newaetech/ChipJabber-Unplugged/docs/img/cj_meterdetail_web.jpg

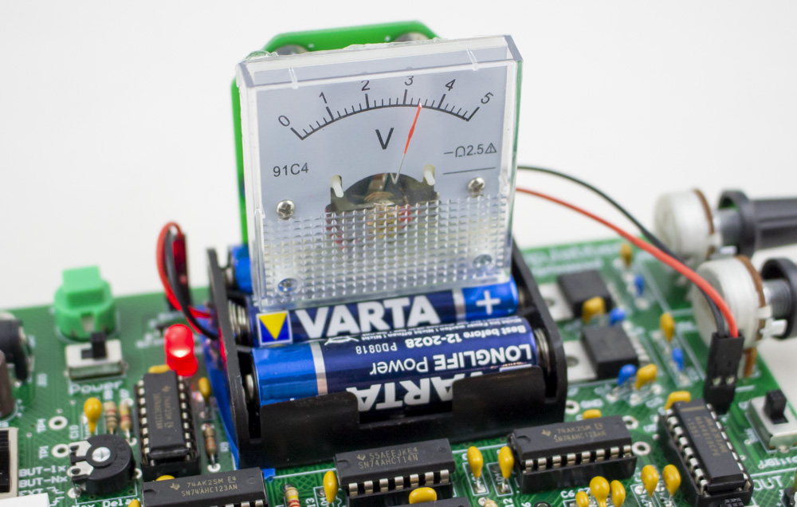
docs/img/cj_meterdetail_web.jpg
