newaetech/ChipJabber-Unplugged/docs/img/cj_notduino_demo_web.jpg

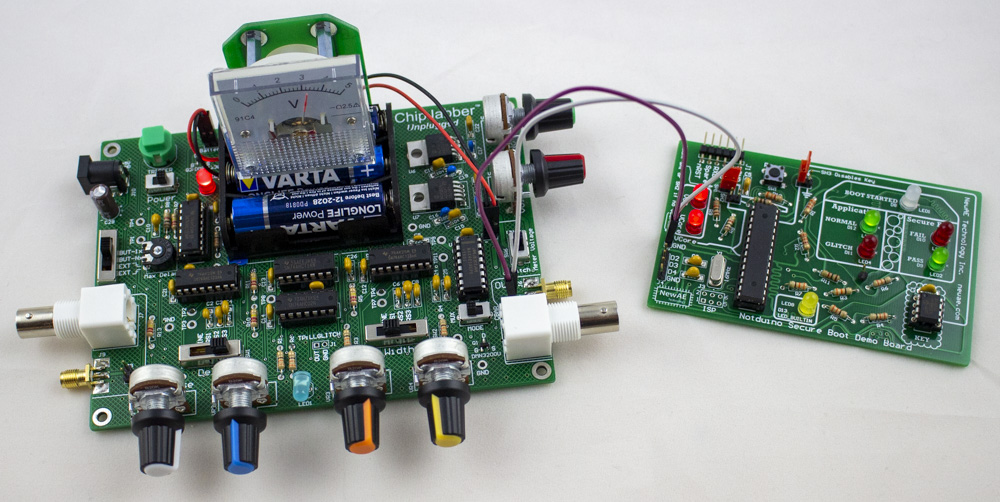
docs/img/cj_notduino_demo_web.jpg
