newaetech/ChipJabber-Unplugged/docs/img/cj_pcb_detail_web.jpg

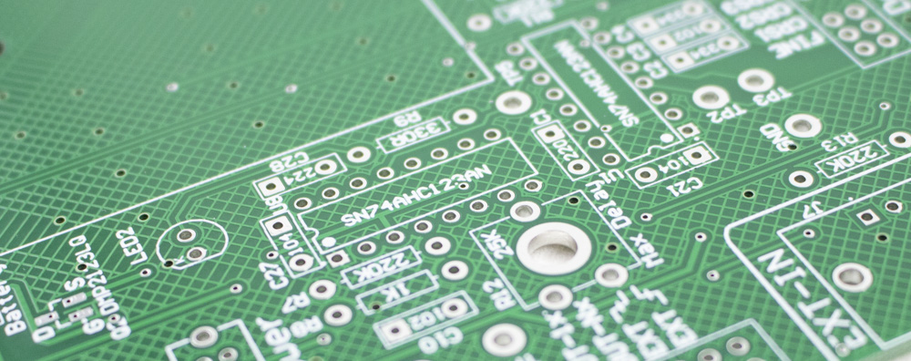
docs/img/cj_pcb_detail_web.jpg
