newaetech/ChipJabber-Unplugged/chipjabber-simple-pcb/chipjabber-unplugged-simplepcb-schematic.PDF

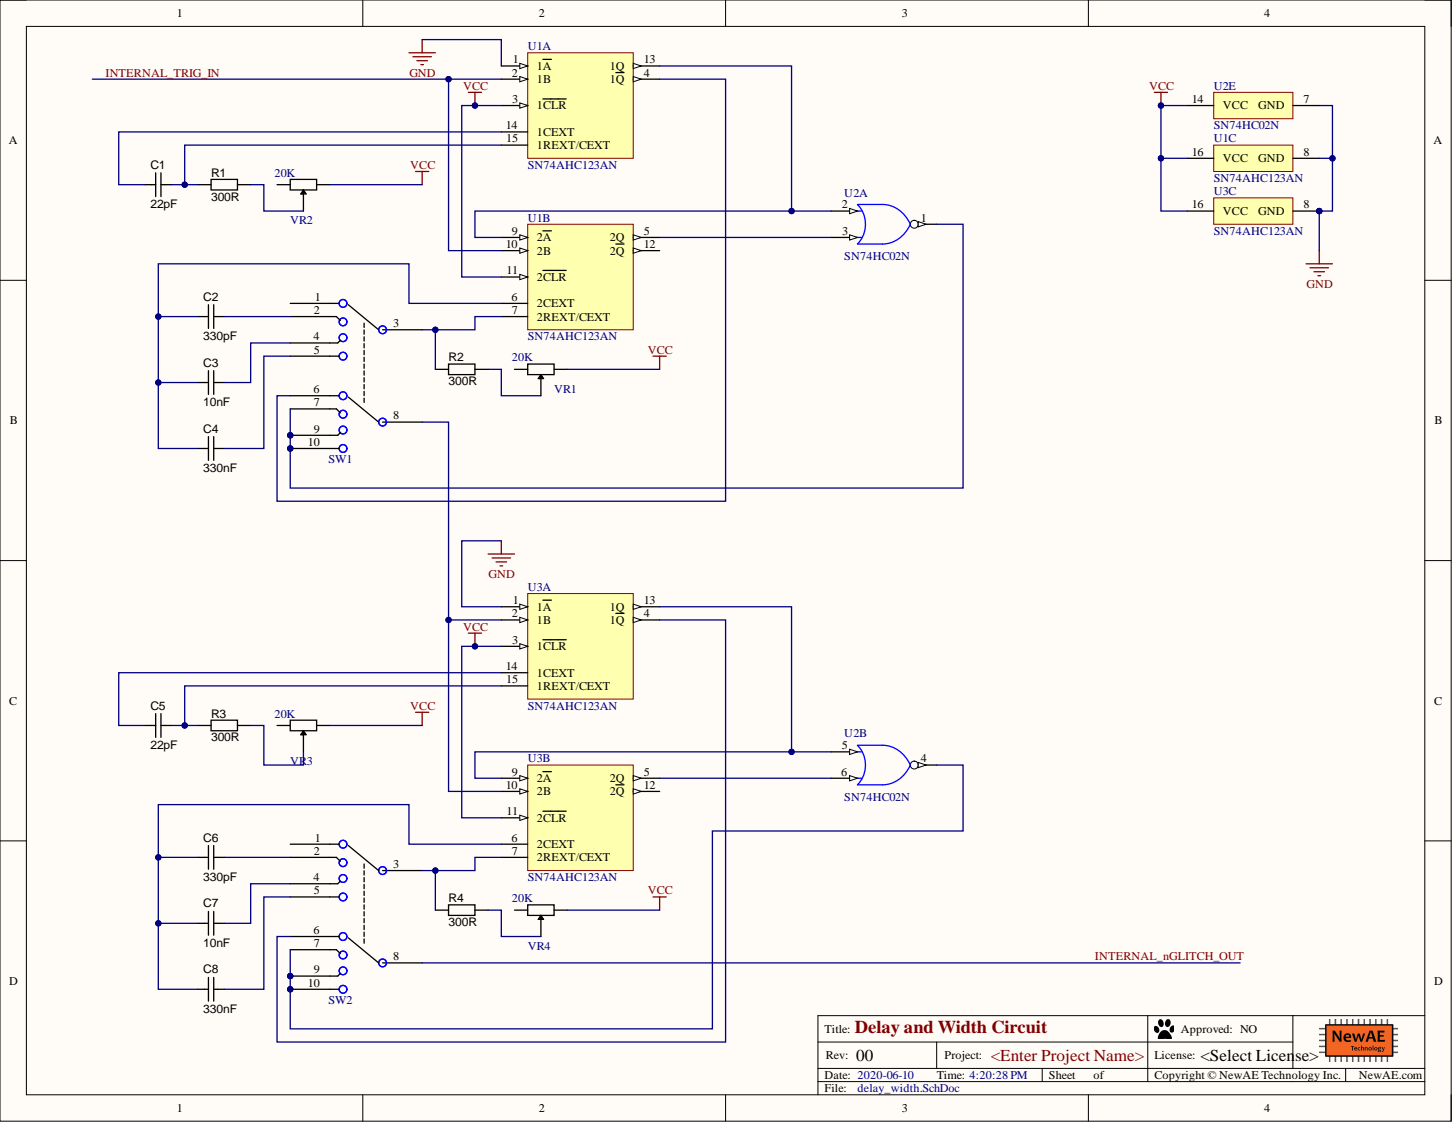
[picture p14: page 1]

1B 2 1CLR 3

1CEXT 14

VCC | | 1CLR 3

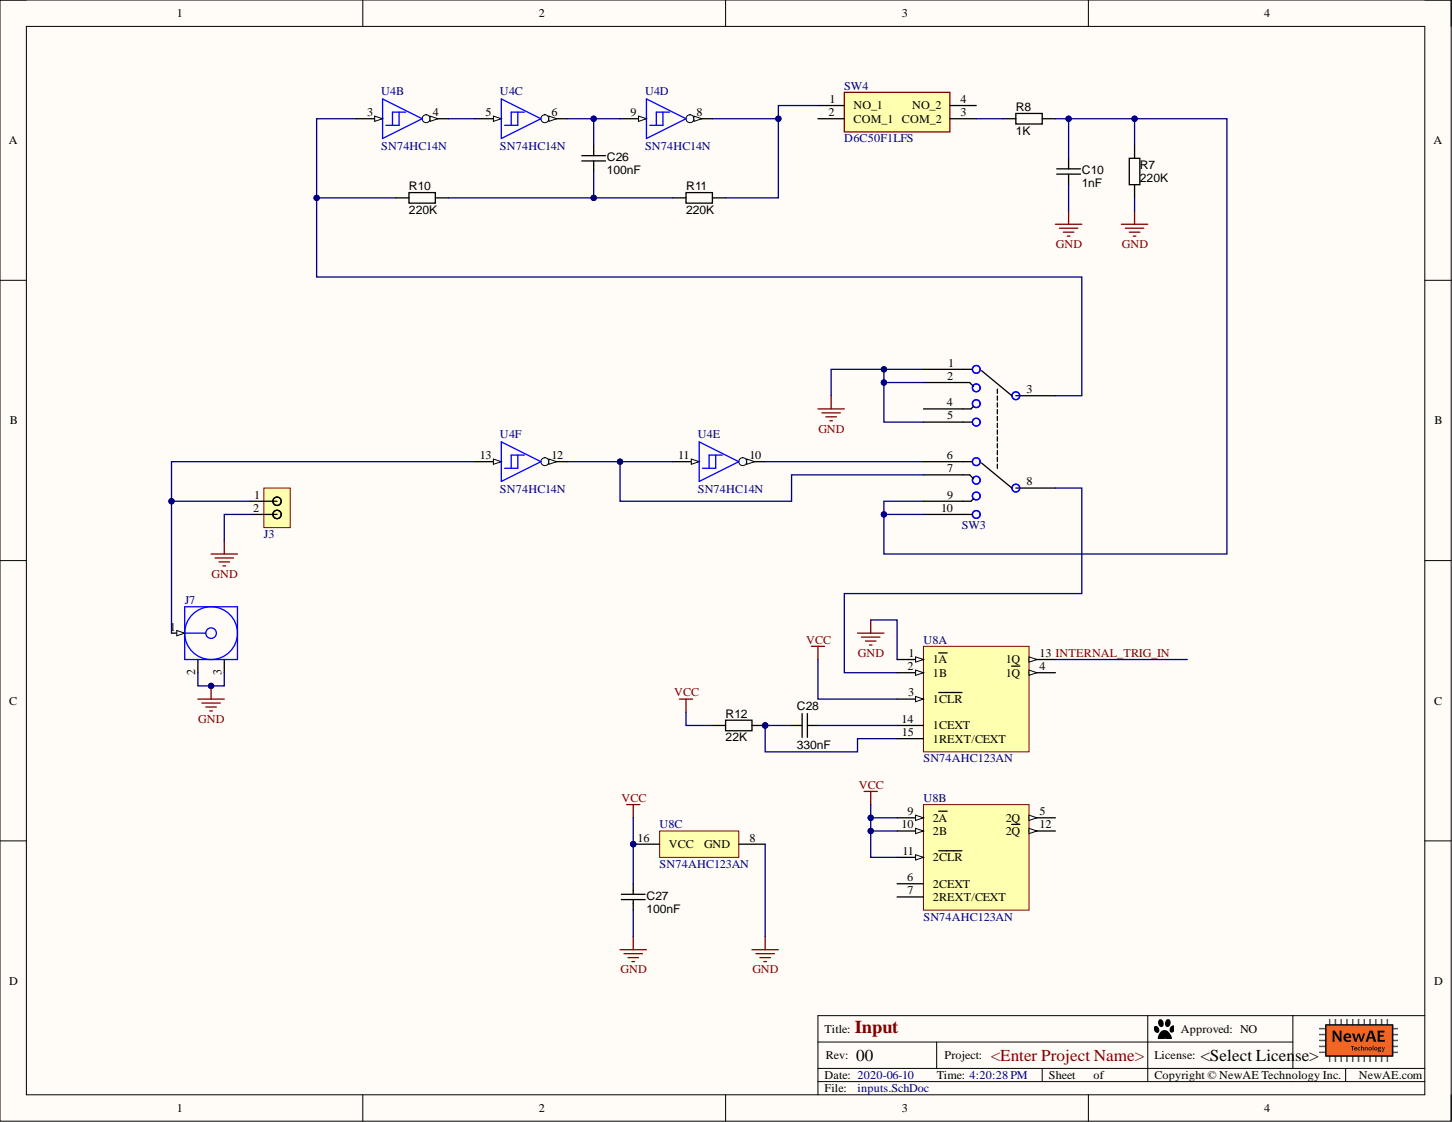
[picture p15: page 2]

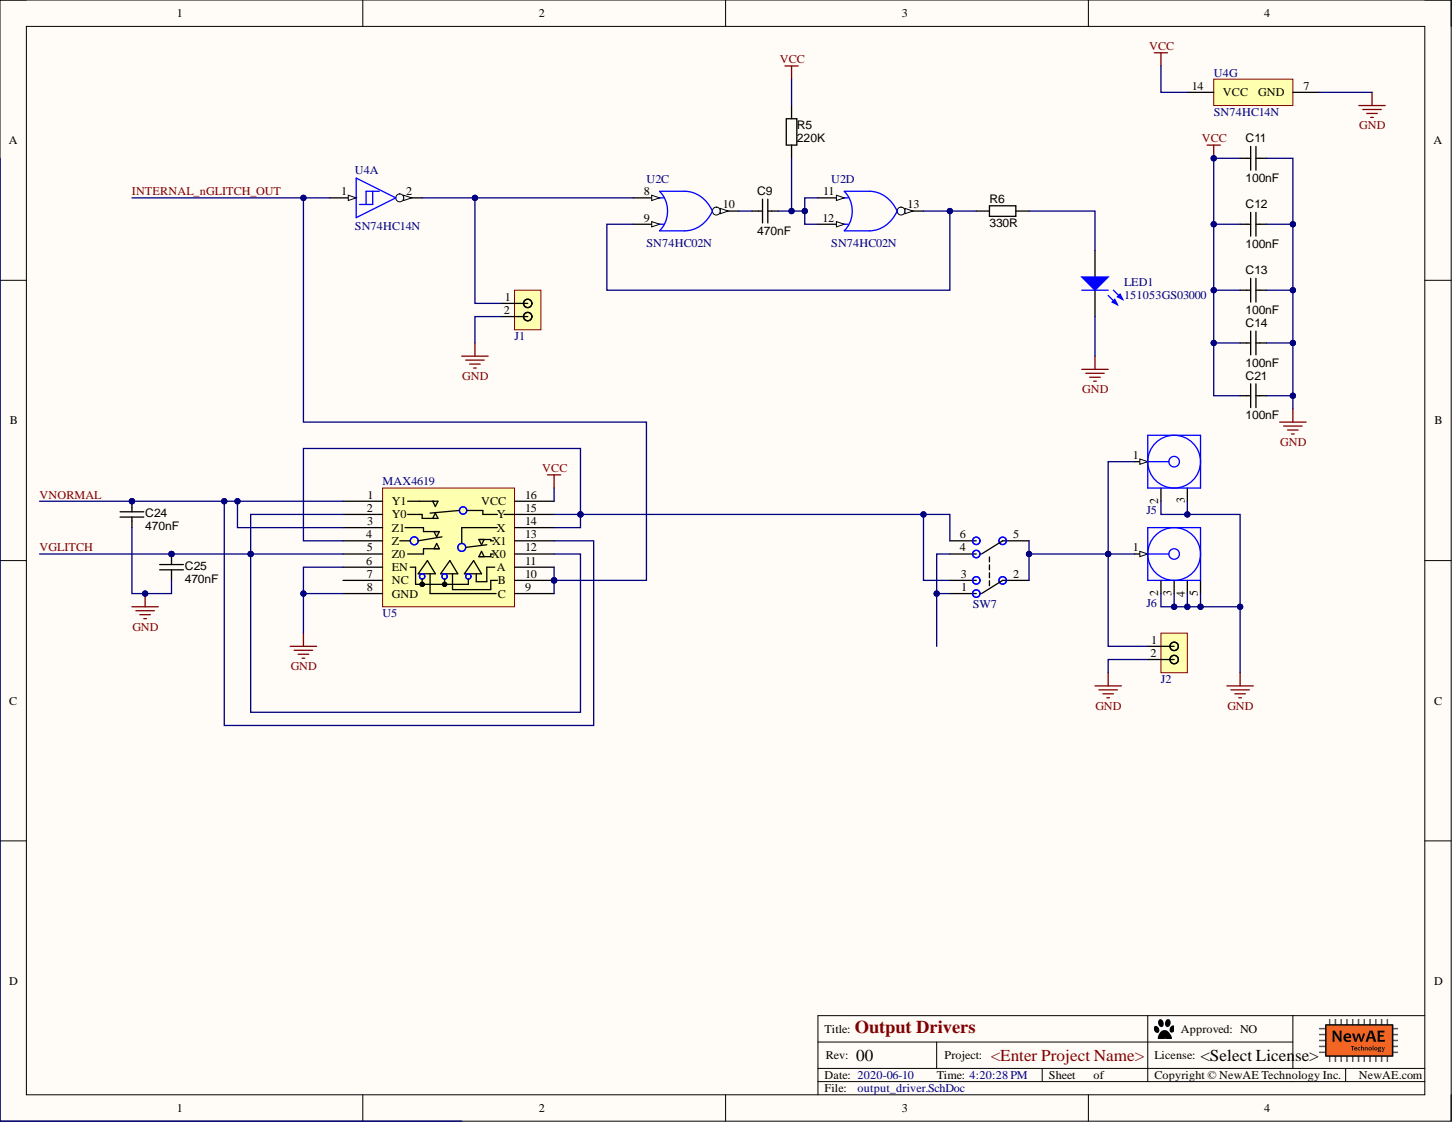
[picture p16: page 3]

MAX4619 | VCC

GND 8 Z1 3 | 9 B 10 A 11 X0 12 X1 13 X 14 Y 15 VCC 16

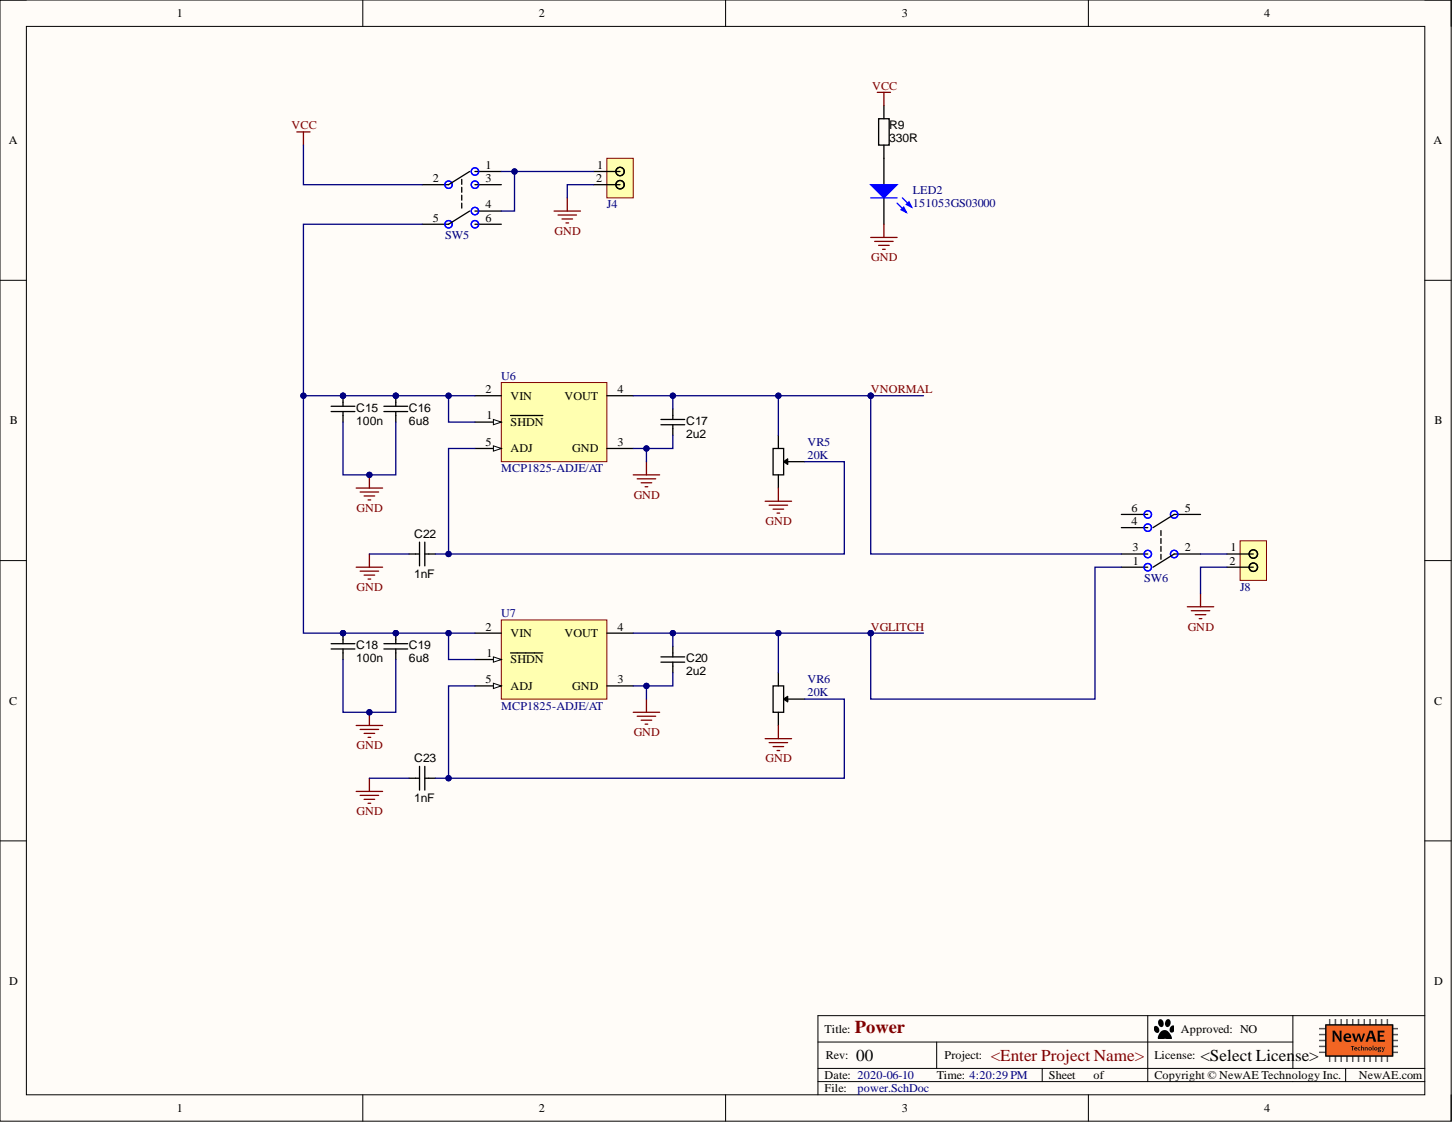
[picture p17: page 4]
