newaetech/ChipJabber-Unplugged/chipjabber-simple-pcb/chipjabber-unplugged-pcbprint.PDF

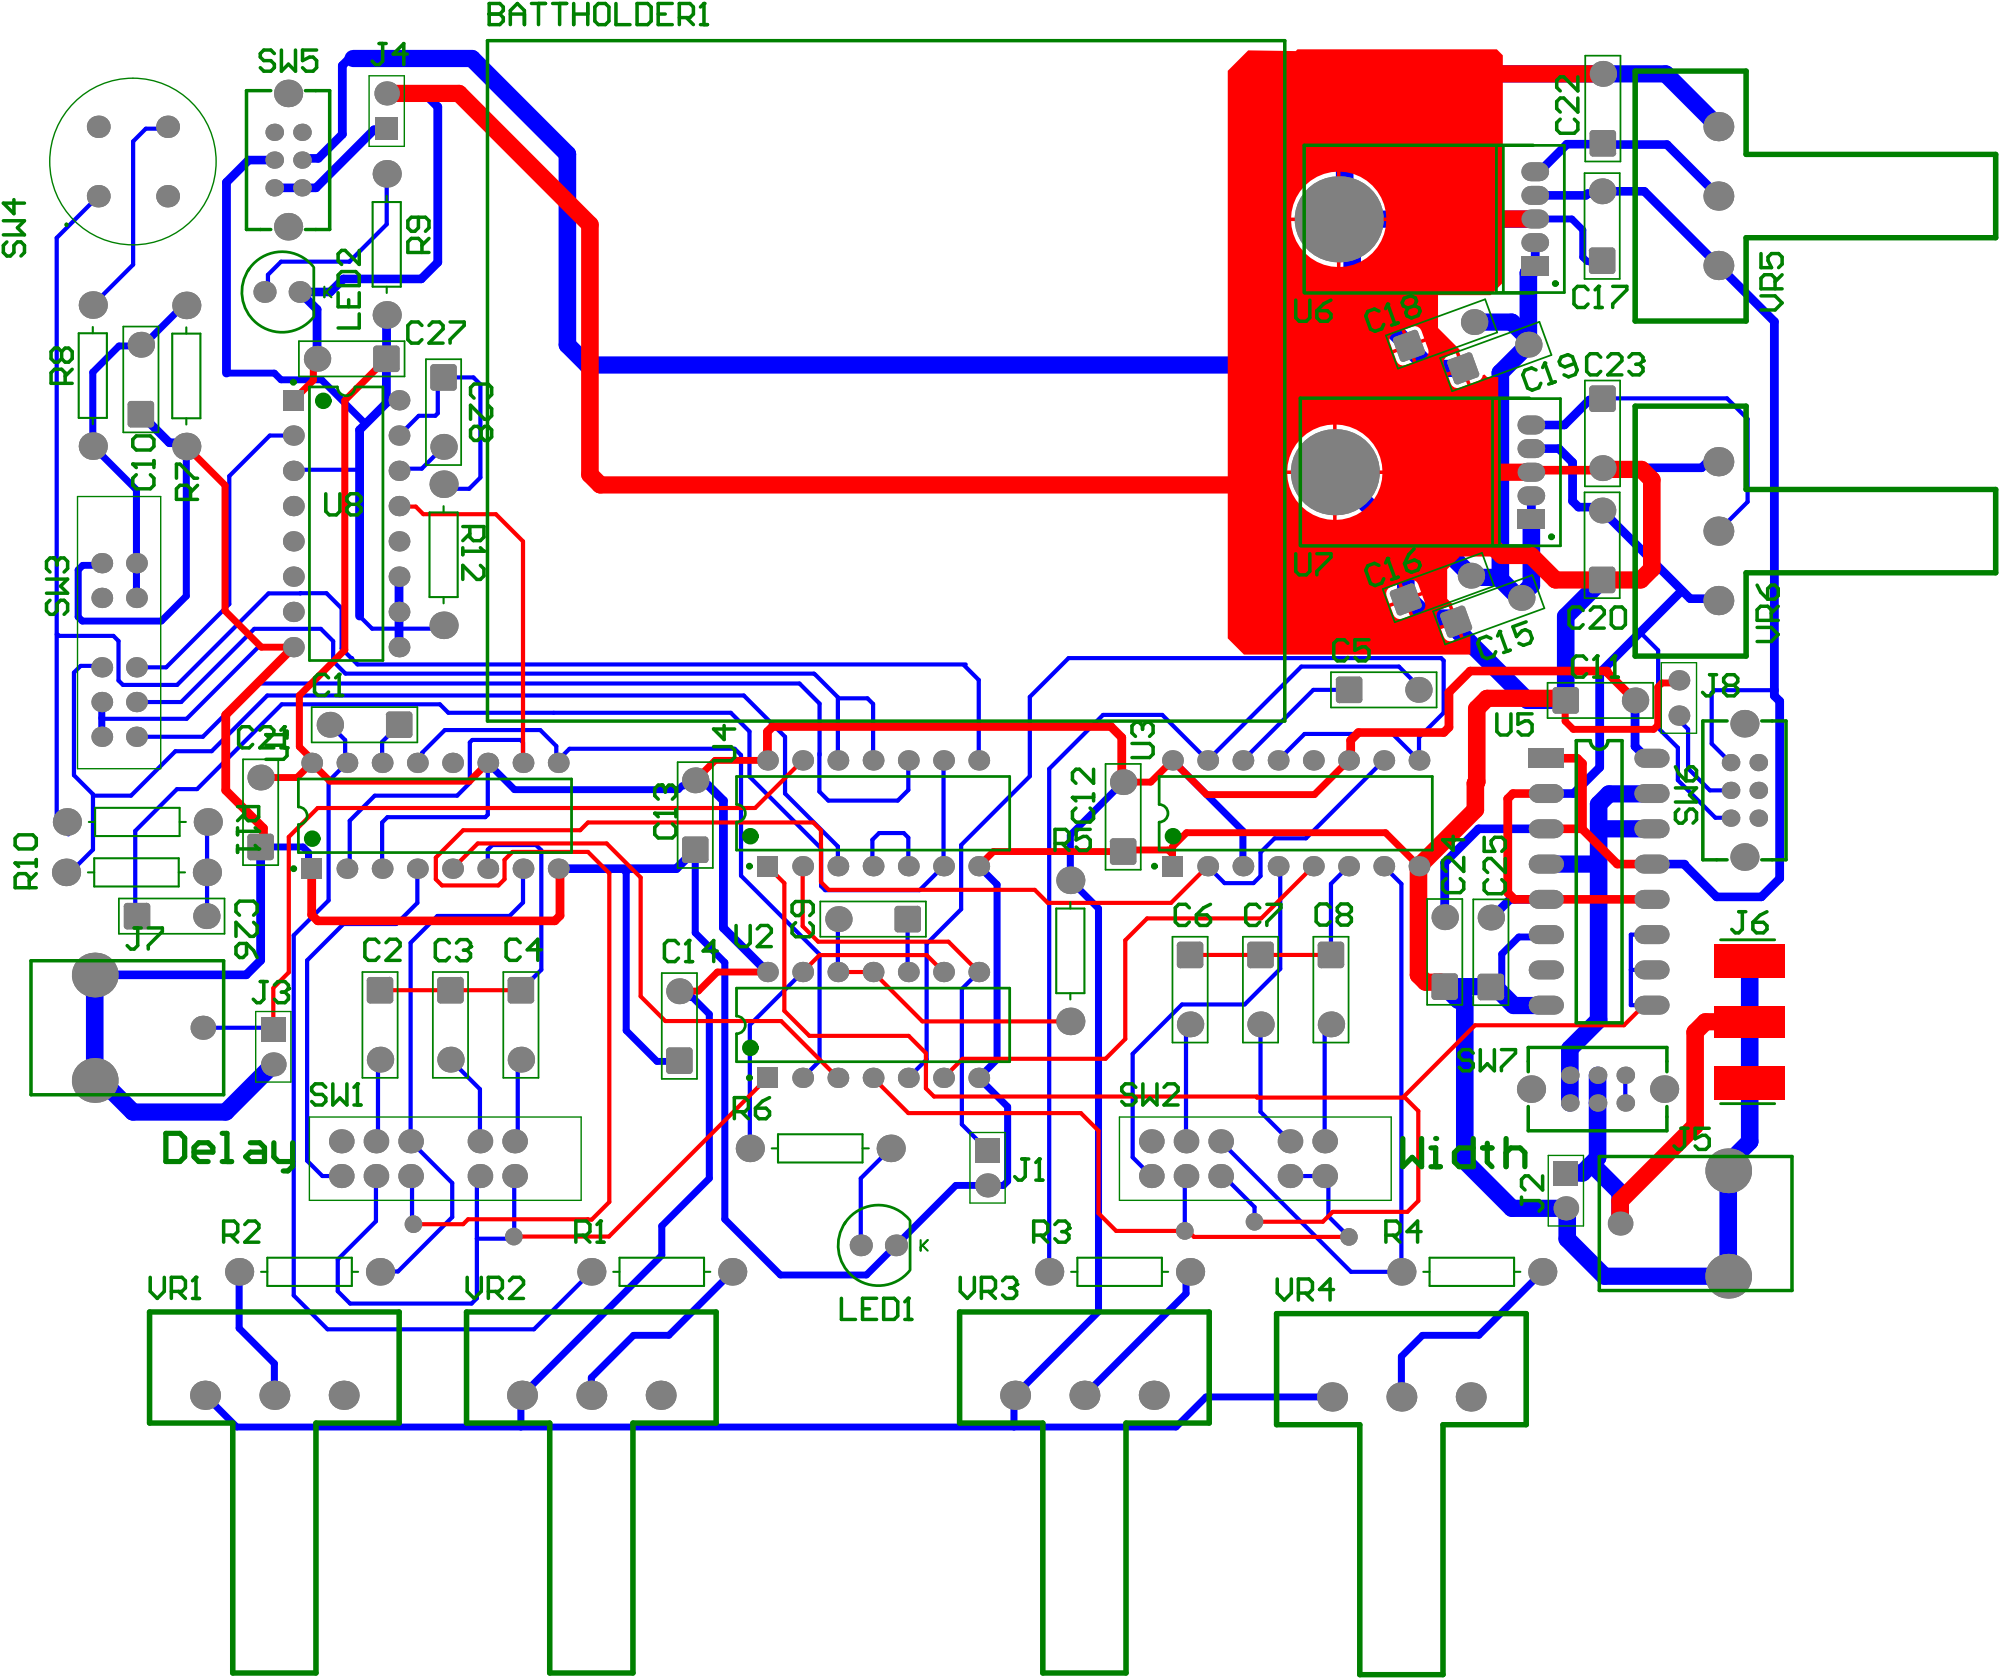
[picture p18: page 1]
