newaetech/ChipJabber-Unplugged/(list of files, drawings)

Other design files:
chipjabber-simple-pcb/Atlium_BobPeaseGlitcher/Atlium_BobPeaseGlitcher.PrjPcb
chipjabber-simple-pcb/Atlium_BobPeaseGlitcher/delay_width.SchDoc
chipjabber-simple-pcb/Atlium_BobPeaseGlitcher/inputs.SchDoc
chipjabber-simple-pcb/Atlium_BobPeaseGlitcher/output_driver.SchDoc
chipjabber-simple-pcb/Atlium_BobPeaseGlitcher/power.SchDoc
chipjabber-simple-pcb/Atlium_BobPeaseGlitcher/solder_glitcher.PcbDoc
