newaetech/ChipJabber-Unplugged/(commit log)

2020-06-10 Add mkdocs github flow
2020-06-10 Add simple PCB, update docs
    [Atlium_BobPeaseGlitcher.PrjPcb, delay_width.SchDoc, inputs.SchDoc, output_driver.SchDoc, power.SchDoc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]
2020-06-10 Push bug-fix to simple PCB...
    [inputs.SchDoc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]
2020-06-10 Add pcb image
2020-06-11 Update simple PCB screenshot
